KarmanLine630/Two-axis-stepper-motor-pan-tilt-platform-and-visual-tracking-project/Hardware/PCB_Schematic/步进电机驱动板bom清单.xlsx

No. | Quantity | Comment | Designator | Footprint | Value | Manufacturer Part | Manufacturer | Supplier Part | Supplier
1 | 3 | 1uf | C1,C3,C5 | C0805 | 1uf
2 | 1 | 220uF | C2 | CAP-SMD_BD10.0-L10.3-W10.3-LS11.3-FD | 220uF | UWT1H221MNL1GS | Nichicon(尼吉康) | C125977 | LCSC
3 | 1 | 330uF | C4 | CAP-SMD_BD10.0-L10.3-W10.3-FD | 330uF | GYA1E331MCQ1GS | Nichicon(尼吉康) | C251006 | LCSC
4 | 1 | 33nf | C6 | C0603 | 33nf
5 | 4 | 1uf | C7,C8,C9,C10 | C0603 | 1uf
6 | 1 | SS54 | D1 | SMC_L7.1-W6.2-LS8.1-R-RD |  | SS54 | YANGJIE(扬杰) | C211777 | LCSC
7 | 1 | X6511FV-04-C85D32 | H1 | HDR-TH_4P-P2.54-V-F |  | X6511FV-04-C85D32 | XKB Connection(中国星坤) | C718241 | LCSC
8 | 3 | PZ254V-11-04P | H2,H4,H8 | HDR-TH_4P-P2.54-V-M |  | PZ254V-11-04P | XFCN(兴飞) | C2691448 | LCSC
9 | 1 | X6511FV-08-C85D32 | H3 | HDR-TH_8P-P2.54-V-F |  | X6511FV-08-C85D32 | XKB Connection(中国星坤) | C718237 | LCSC
10 | 3 | PZ254V-12-10P | H5,H6,H7 | HDR-TH_10P-P2.54-V-M-R2-C5-S2.54 |  | PZ254V-12-10P | XFCN(兴飞) | C492422 | LCSC
11 | 1 | PZ254V-11-06P | H9 | HDR-TH_6P-P2.54-V-M |  | PZ254V-11-06P | XFCN(兴飞) | C492405 | LCSC
12 | 2 | 2.54-1*20P直针 | J1,J2 | HDR-TH_20P-P2.54-V-M-1 |  | 2.54-1*20P直针 | BOOMELE(博穆精密) | C50981 | LCSC
13 | 1 | 47uH | L1 | IND-SMD_L13.5-W12.6_TMPA1265SP-100MN-D | 47uH | MDA1365-470M | KOHERelec(科或) | C2847587 | LCSC
14 | 1 | LED_0603-R | LED1 | LED_0603
15 | 1 | LED_0603-G | LED2 | LED_0603
16 | 3 | LED_0603-B | LED3,LED4,LED5 | LED_0603
17 | 10 | 10K | R1,R3,R4,R5,R6,R7,R8,R9,R10,R11 | R0603 | 10K
18 | 1 | 3.3K | R2 | R0603 | 3.3K
19 | 4 | M3螺丝 | SCREW1,SCREW2,SCREW3,SCREW4 | M3螺丝
20 | 3 | SS-12D10L5 | SW1,SW2,SW3 | SW-TH_SS-12D10L5 |  | SS-12D10L5 | XKB Connection(中国星坤) | C319012 | LCSC
21 | 4 | Key_TH_6x6x6 | SW8,SW9,SW10,SW11 | SW-TH_4P-L6.0-W6.0-P4.50-LS6.5
22 | 1 | STM32F1030C8T6最小系统板 | U1 | STM32F103C8T6核心板 |  | STM32F103C8T6最小系统模块 | 无 | C8734
23 | 1 | XL4015E1 | U2 | TO-263-5_L10.2-W8.9-P1.70-TL |  | XL4015E1 | XLSEMI(芯龙) | C51661 | LCSC
24 | 2 | XT60PB-M | U3,U4 | CONN-TH_XT60PB-M |  | XT60PB-M |  | C9900017179 | LCSC
25 | 2 | 2.54-2*20 | U6,U7 | HDR-TH_40P-P2.54-V-F-R2-C20-S2.54 |  | 2.54-2*20 | ZHOURI(洲日) | C2977589 | LCSC
26 | 2 | KF301-5.0-2P | U8,U9 | CONN-TH_P5.00_KF301-5.0-2P |  | KF301-5.0-2P | KEFA(科发) | C474881 | LCSC
