KarmanLine630/Two-axis-stepper-motor-pan-tilt-platform-and-visual-tracking-project/Hardware/PCB_Schematic/原理图设计.pdf

# USBSTM32F1030C8T6核心板

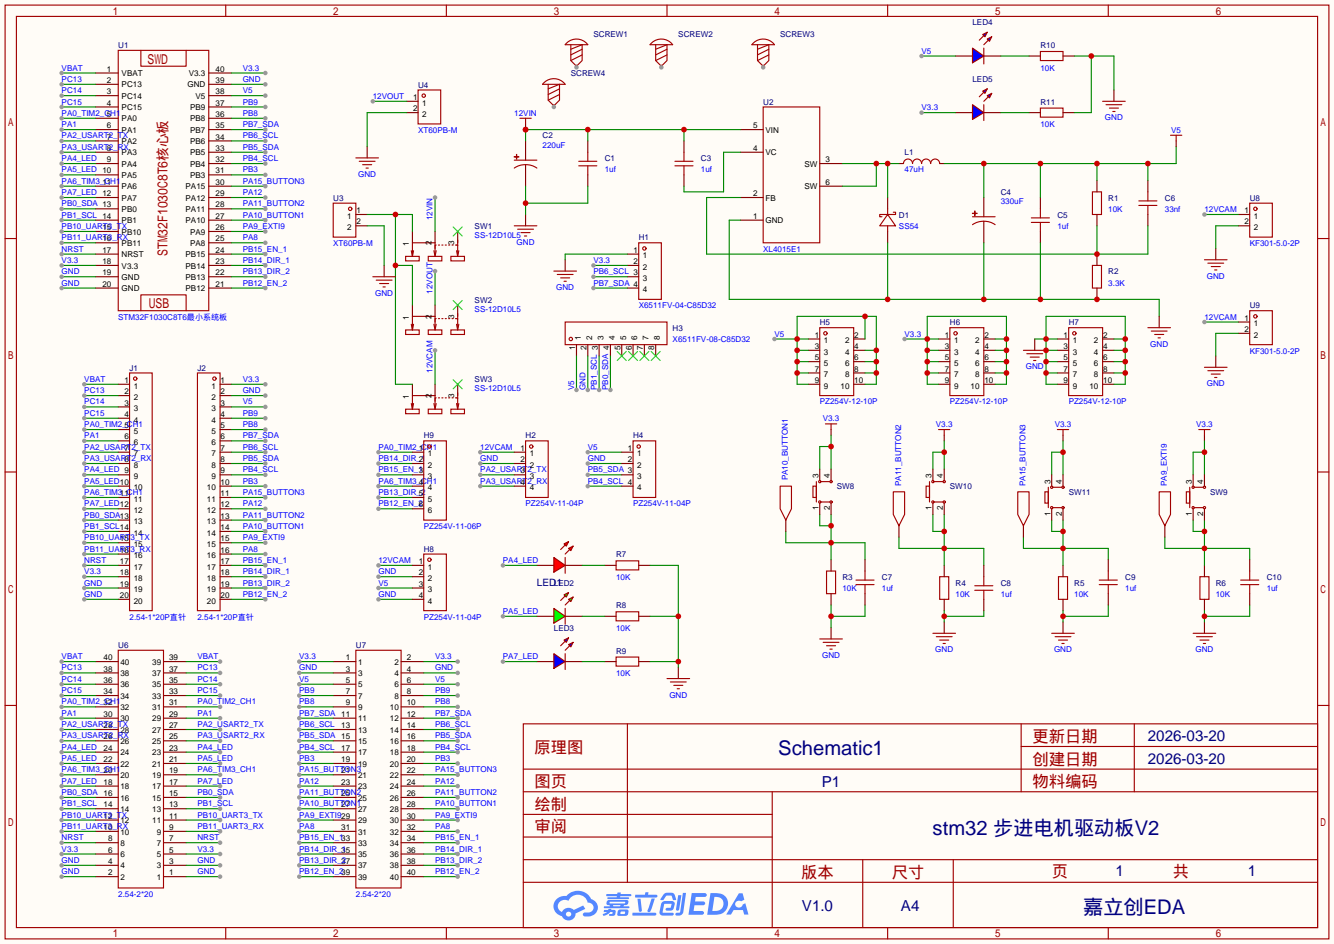
[picture p1: page 1]
