KarmanLine630/Two-axis-stepper-motor-pan-tilt-platform-and-visual-tracking-project/Core/Inc/main.h

#define EN_2_Pin GPIO_PIN_12
#define EN_2_GPIO_Port GPIOB
#define dir_2_Pin GPIO_PIN_13
#define dir_2_GPIO_Port GPIOB
#define dir_1_Pin GPIO_PIN_14
#define dir_1_GPIO_Port GPIOB
#define EN_1_Pin GPIO_PIN_15
#define EN_1_GPIO_Port GPIOB
#define button1_Pin GPIO_PIN_10
#define button1_GPIO_Port GPIOA
#define button2_Pin GPIO_PIN_11
#define button2_GPIO_Port GPIOA
#define button3_Pin GPIO_PIN_15
#define button3_GPIO_Port GPIOA
